ailsa-sun/Hope-Analog-Synth/Synth/Synth.kicad_pcb

## KiCad design Synth/Synth.kicad_pcb (2024-04-12)

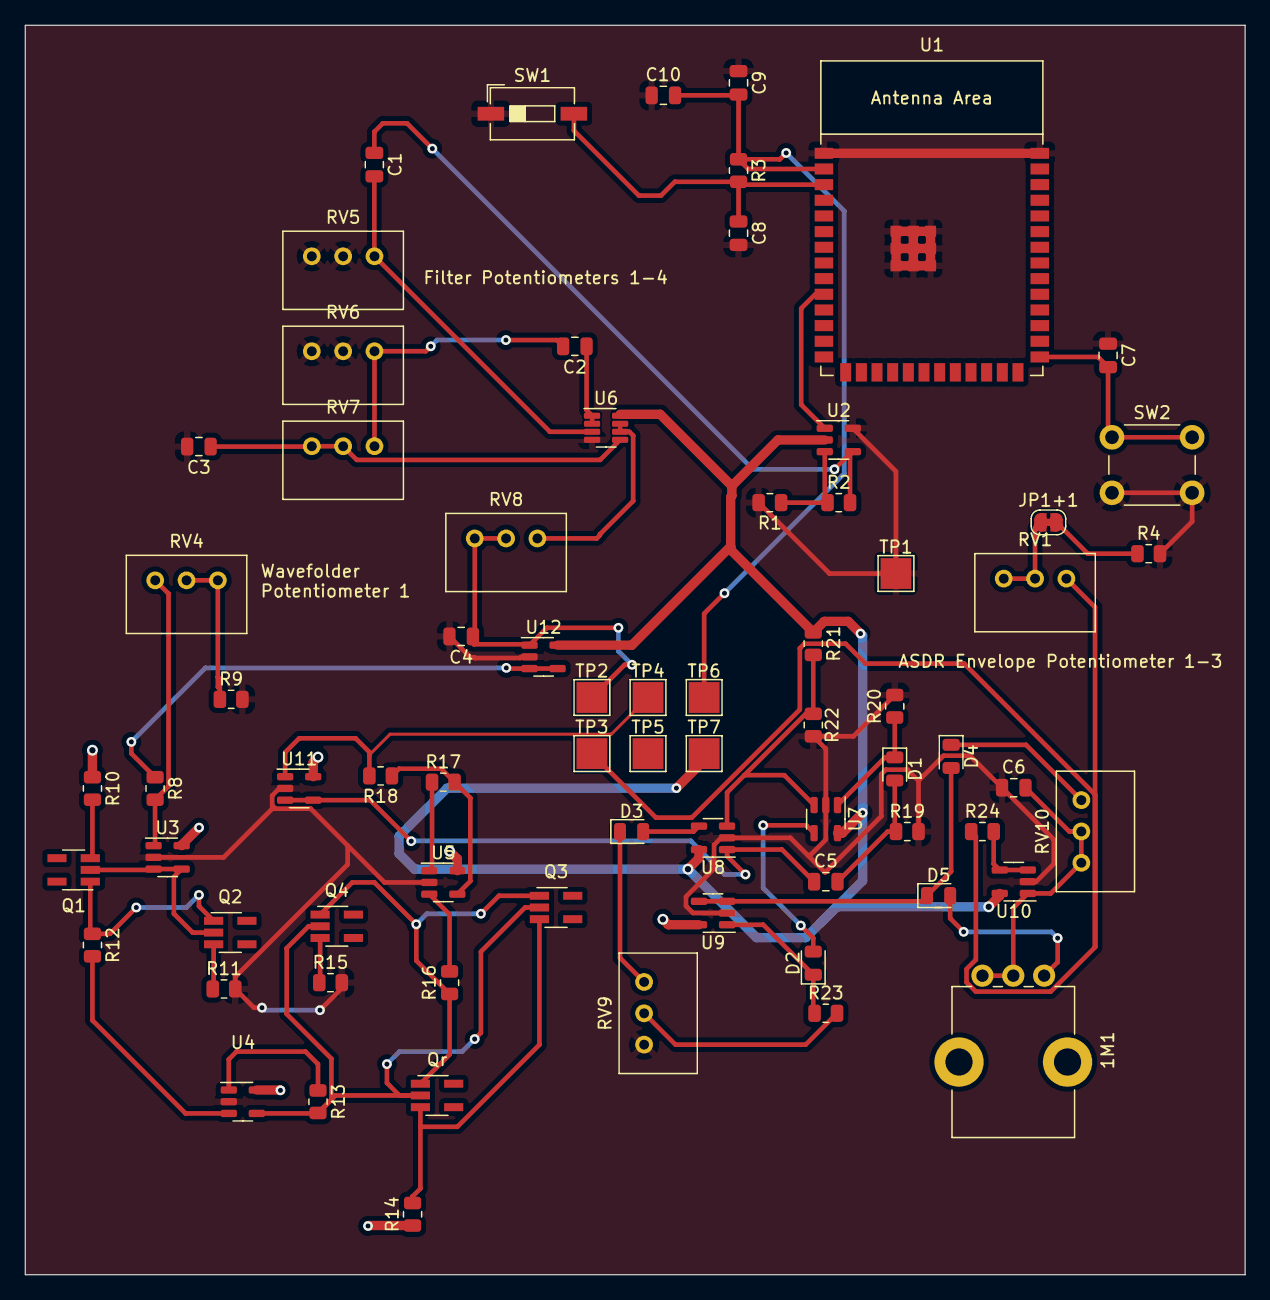
[picture p1: board Synth.kicad_pcb from above]

Board: 2 copper layers, 98.9 x 101.3 mm, 72 parts (0 on the bottom side), 48 nets.

Parts:
1M1: R_Potentiometer; Potentiometer_Bourns_PTV09A-1_Single_Vertical
C1, C2, C3, C4: C; C_0805_2012Metric
C5, C6, C10: 1uF; C_0805_2012Metric
C7, C8, C9: 0.1uF; C_0805_2012Metric
D1: D_0805_2012Metric
D2, D3, D4, D5: D; D_0805_2012Metric
JP1+1: SolderJumper_2_Open; SolderJumper-2_P1.3mm_Bridged_RoundedPad1.0x1.5mm
Q1, Q3: PNP; SOT-23-5_HandSoldering
Q2, Q4: NPN; SOT-23-5_HandSoldering
Qr: PNP; SOT-23-5_HandSoldering
R1, R18, R24: 1k; R_0805_2012Metric
R2: 1.7k; R_0805_2012Metric
R3, R12, R16, R19: 10k; R_0805_2012Metric
R4, R10, R11, R13, R14, R15: 20k; R_0805_2012Metric
R8, R20, R21, R23: 100k; R_0805_2012Metric
R9: 2k; R_0805_2012Metric
R17: 220k; R_0805_2012Metric
R22: 47k; R_0805_2012Metric
RV1, RV4: 20k; Potentiometer_Bourns_3299W_Vertical
RV5, RV6, RV7, RV8: R_Potentiometer; Potentiometer_Bourns_3299W_Vertical
RV9: 100k; Potentiometer_Bourns_3299W_Vertical
RV10: 1M; Potentiometer_Bourns_3299W_Vertical
SW1: Reset; SW_DIP_SPSTx01_Slide_6.7x4.1mm_W6.73mm_P2.54mm_LowProfile_J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
SW2: Boot; SW_PUSH_6mm_H7.3mm
TP1, TP2, TP3, TP4, TP5, TP6, TP7: TestPoint; TestPoint_Pad_2.5x2.5mm
U1: ESP32-S2-SOLO
U2, U3, U4, U5, U7, U8, U9, U10, U11, U12: LM321; SOT-23-5
U6: Opamp_Dual; TSOT-23-8

Connections:
+3.3V: C9.2, C10.2, R3.1, TP6.1, U1.2 (3V3)
+12V: R10.1, R14.1, R21.1, TP7.1, U2.2 (V-), U3.5 (V+), U4.5 (V+), U5.5 (V+), U6.8 (V+), U7.5 (V+), U8.5 (V+), U9.5 (V+), U10.5 (V+), U11.5 (V+), U12.5 (V+)
ESP Out: C1.1, R2.2, U2.4
Filter Output: C4.1, RV8.2, RV8.3, TP2.1, U12.1 (+)
GND: C3.2, C4.2, C6.1, C7.1, C8.2, C9.1, C10.1, R1.2, R4.2, R9.2, R11.2, R15.2, R19.2, R20.2, R22.2, RV5.2, RV5.3, RV6.2, RV6.3, RV9.3, SW1.1, SW2.2, TP1.1, U1.1 (GND), U1.40 (GND), U1.41 (GND), U2.5 (V+), U3.2 (V-), U4.2 (V-), U5.2 (V-), U6.4 (V-), U7.2 (V-), U8.2 (V-), U9.2 (V-), U10.2 (V-), U11.2 (V-), U12.2 (V-)
LowPass Input: C2.2, RV6.1, RV7.1
unnamed: C5.2, D1.2 (A), R19.1
unnamed: D1.1 (K), R20.1, U7.1 (+)
unnamed: D2.2 (A), U7.4
unnamed: D2.1 (K), R23.1, U9.1 (+)
unnamed: D3.2 (A), U8.4
unnamed: D3.1 (K), RV9.1
unnamed: D4.2 (A), D5.1 (K), U9.3 (-), U9.4
unnamed: D4.1 (K), RV10.1
unnamed: 1M1.3, D5.2 (A)
unnamed: JP1+1.1 (A), RV1.2, RV1.3
unnamed: JP1+1.2 (B), R4.1
unnamed: Q1.2 (B), Q2.2 (B), U3.3 (-), U3.4
unnamed: Q1.1 (C), Q2.1 (C), R12.1
unnamed: Q1.3 (E), R10.2
unnamed: Q2.3 (E), R11.1
unnamed: Q3.2 (B), Q4.2 (B), Qr.2 (B), R13.2, U4.4
unnamed: Q3.1 (C), Q4.1 (C), Qr.1 (C), R16.1
unnamed: Q3.3 (E), Qr.3 (E), R14.2
unnamed: Q4.3 (E), R15.1
unnamed: R9.1, RV4.1, RV4.2
unnamed: R17.2, R18.1, U5.4
unnamed: R23.2, RV9.2
unnamed: C8.1, R3.2, SW1.2, U1.3 (EN)
unnamed: C7.2, SW2.1, U1.27 (GPIO0)
unnamed: U1.10 (GPIO17/U1TXD/ADC2_CH6/DAC_1), U2.1 (+)
unnamed: R1.1, R2.1, U2.3 (-)
unnamed: R8.2, RV4.3, U3.1 (+)
unnamed: R13.1, U4.1 (+)
unnamed: R12.2, U4.3 (-)
unnamed: R17.1, U5.1 (+)
unnamed: R16.2, U5.3 (-)
unnamed: C1.2, RV5.1, U6.3 (+)
unnamed: C2.1, U6.1, U6.2 (-)
unnamed: C3.1, RV7.2, RV7.3, U6.5 (+)
unnamed: RV8.1, U6.6 (-), U6.7
unnamed: R21.2, R22.1, U7.3 (-), U8.3 (-)
unnamed: 1M1.1, 1M1.2, C6.2, RV10.2, RV10.3, U10.1 (+)
unnamed: R24.2, U10.3 (-), U10.4
V_Wavefolder+: R18.2, TP4.1, U11.1 (+)
V_inWF+: R8.1, U12.3 (-), U12.4
V_in_EN+: C5.1, U8.1 (+), U11.3 (-), U11.4
V_out+: R24.1, RV1.1, TP3.1
