ailsa-sun/Hope-Analog-Synth/(commit log)

2024-03-11 added 3-channel mixer
    [Synth.kicad_pcb, Synth.kicad_sch, mixer.kicad_sch]
2024-03-13 added in double wavefolder
    [Synth.kicad_sch, wavefolder.kicad_sch]
2024-03-14 adding Ailsa's version w/ high/low pass filter
    [HOPE.kicad_pcb, HOPE.kicad_sch]
2024-03-14 commit edits to add buffer to filter
    [HOPE.kicad_sch]
2024-03-14 merged to the same file
    [HOPE.kicad_pcb, HOPE.kicad_sch, Synth.kicad_sch, untitled.kicad_sch]
2024-03-17 fixed erge stuff fingers crossed
    [Synth.kicad_sch, envelope.kicad_sch, mixer.kicad_sch, untitled.kicad_sch, wavefolder.kicad_sch]
2024-04-09 removed mixer
    [Synth.kicad_sch, wavefolder.kicad_sch]
2024-04-11 added some footprints
    [Synth.kicad_pcb, envelope.kicad_sch, untitled.kicad_sch, wavefolder.kicad_sch]
2024-04-11 add the layout
    [Synth.kicad_sch, envelope.kicad_sch, untitled.kicad_sch, wavefolder.kicad_sch]
2024-04-11 fixed erc errs
    [Synth.kicad_sch, envelope.kicad_sch, untitled.kicad_sch, wavefolder.kicad_sch]
2024-04-11 add the ESP
    [Synth.kicad_sch, untitled.kicad_sch]
2024-04-11 changed the resistor valuess
    [Synth.kicad_sch]
2024-04-11 changed the potentiometer footprints
    [Synth.kicad_pcb, Synth.kicad_sch, envelope.kicad_sch, untitled.kicad_sch, wavefolder.kicad_sch]
2024-04-11 almost done w layoutgit add *
    [Synth.kicad_pcb, Synth.kicad_sch, untitled.kicad_sch]
2024-04-11 made small changes, fixed DRC Errors
    [Synth.csv, Synth.kicad_pcb, envelope.kicad_sch]
2024-04-11 changed hierarchical labels
    [Synth.kicad_sch, envelope.kicad_sch, untitled.kicad_sch, wavefolder.kicad_sch]
2024-04-11 Commit the changes to the thing
    [Synth.kicad_pcb]
